BHP1000/TC_Charger/(commit log)

2026-04-05 Initial release: ESP32-S3 CAN controller for HK-LF-115-58 6.6kW OBC
    - Full CAN bus control (250kbps, extended frames) for TC Standard charger
    - Serial command interface: resume/stop/sleep/wake, voltage/current adjust
    - Buddy charge mode for charging external batteries with auto-restore
    - Energy tracking: session, previous, lifetime (NVS persistent)
    - Range estimation: Wh-to-miles with charge time calculator
    - BLE telemetry + command characteristic (22-byte binary, 1Hz notify)
    - WiFi AP fallback (JSON API at 192.168.4.1)
    - Pulse charging EMA smoothing for accurate display
    - 7-page OLED display, RGB status LED, GPS, compass, NTC thermal array
    - RS485 Modbus to ESP32-C3 daughter board (temp nod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
    [TC Standard OBC CAN Protocal .xlsx]
2026-04-05 Add charger configuration code 9000/HD623 and CAN spec details
2026-04-05 Fix CAN transceiver info: CJMCU-1051 works at 3.3V, only 5V damages ESP32
2026-04-05 Add outlet presets, thermal zones, TEST/DEV mode, CAN inter-module, sensor calibration
    Outlet Presets (saved to NVS):
    - A: 110V/15A (1650W), B: 110V/20A (2200W), C: 110V/30A (3300W)
    - D: 220V/15A (3300W), E: 220V/30A (6600W)
    - G: EV Station (user sets amps, CP dummy resistor)
    - U: User defined (custom voltage + amps)
    - F: TEST/DEV (all safety disabled)
    Thermal Protection (battery temps only, charger temp excluded):
    - NORMAL: <140F, CAUTION: 140-194F, DANGER: 194-248F, CRITICAL: >248F
    - Linear derating through CAUTION (100-50%) and DANGER (50-0%)
    - Per-sensor enable/disable: NTC T1-T5, BMS Temp1/2
    - Per-sensor calibration offset in Fahrenheit, saved to NVS
    Multi-char Command Protocol:
    - OA-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
2026-04-05 Fix declaration ordering: forward decls before first use, remove duplicate defines and dead code
    [TC_Charger_MainBrain.ino]
2026-04-05 Critical code review fixes: declaration ordering, BLE, debounce, safety
    CRITICAL fixes:
    - C1: Move safety_state declaration before CAN driver (was compile error)
    - C2: BLE service handle count increased to 40 (was 15, only 5 chars registered)
    - C3: Add null guard in ble_server_update for partial BLE init
    WARNING fixes:
    - W1: Serial multi-char T commands (TZ, TS, TC) now buffered correctly
    Single 't' for schedule toggle still works via fallthrough
    - W2: Button debounce: check timer BEFORE updating last_raw (was swallowing transitions)
    - W3: Remove incorrect prev session duration calc when session_start==0
    - W6: CAN inter-module SET_AMPS/SET_VOLTS clamped to charger hardware limits
    - W7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
    [TC_Charger_MainBrain.ino]
2026-04-05 Add comprehensive Arduino IDE setup guide with troubleshooting and hardware requirements
2026-04-05 Suppress CAN TX error spam when unplugged, add NVS backup/restore commands
    - Remove per-frame CAN TX error log (STATUS line already shows UNPLUGGED)
    - Add NVS commands for manual value restore after flash erase:
    ND - Dump all NVS values with restore commands
    NLW,500 - Set lifetime Wh
    NLA,6.5 - Set lifetime Ah
    NE,32.0 - Set efficiency Wh/mile
    - ND output includes exact restore commands for every saved setting
    - Works via Serial, BLE, and WiFi
    [TC_Charger_MainBrain.ino]
2026-04-05 Add comprehensive USER_GUIDE.md, suppress CAN TX spam, update README
    - USER_GUIDE.md: Complete operating manual covering all features:
    Quick start, all commands reference, charge profiles, outlet presets,
    buddy mode, maintenance mode, scheduled charging, thermal protection,
    sensor calibration, TEST/DEV mode, energy tracking, NVS backup/restore,
    BLE/WiFi API reference, CAN inter-module protocol, OLED pages,
    RGB LED states, and troubleshooting guide
    - README.md: Added hardware requirements section with minimum specs,
    comprehensive Arduino IDE setup with every Tools menu setting,
    troubleshooting for boot loops, blank serial, and flash errors
    - Firmware: Suppressed CAN TX error spa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
2026-04-05 Add cost tracking, completion notifications, thermal prediction, time-to-target, GPS source selection
    Electricity Cost Tracking:
    - NC,0.12: set cost per kWh, NF,42.30: restore lifetime cost
    - Per-outlet cost rate (EV stations default to free)
    - Session cost, lifetime cost (paid), free charger kWh tracked separately
    - Saved to NVS, shown in status line and p report
    Charge Completion Notification:
    - BLE notification via session_end characteristic (...26b2)
    - 22-byte packet: start/end voltage, Wh, Ah, duration, profile, outlet, cost
    - Buzzer GPIO support (set BUZZER_PIN, -1 = disabled)
    - App receives packet to log full charge history
    Time-to-Target Estimates:
    - p report shows estimated minute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
    [TC_Charger_MainBrain.ino]
2026-04-05 Replace buzzer with BLE notify + RGB flash, add TPMS CAN listener
    - Remove buzzer GPIO code, replace completion alert with RGB LED flash (3x green)
    - BLE notification still sent on charge complete (session end characteristic)
    - Add TPMS data receiver from VESC module via CAN (0x1C000010)
    - Front/rear PSI and temperature (Fahrenheit)
    - Toggleable: TPMS1 (enable) / TPMS0 (disable)
    - 60-second timeout marks sensor data as STALE
    - Shown in p report and WiFi /status JSON
    - Physical switches/buttons with LEDs planned for future GPIO wiring
    Compiled: 1,337,123 bytes (42%), 52,760 bytes RAM (16%)
    [TC_Charger_MainBrain.ino]
2026-04-07 v2.0.0: NimBLE migration, TPMS BLE scanner, MQTT, direct commands
    Major firmware update:
    - Migrated BLE from stock ESP32 library to NimBLE-Arduino 2.5.0
    - Added TPMS BLE passive scanner for CozyLife/ZEEPIN valve cap sensors
    - TPMS: discovery, MAC assignment, decode, EMA smoothing, slow leak detection
    - Added WiFi STA + MQTT for Home Assistant with auto-discovery
    - Added direct value set commands (SV/SA/SM/SR/SP/SO)
    - Fixed CAN bus-off recovery for charger hot-plug detection
    - Fixed BLE write command handler (NimBLEAttValue)
    - Added firmware versioning, changelog, timestamps on status line
    - Added COMM_INTERFACE_BLUEPRINT.md (full integration reference)
    - Added TPMS_PROTOCOL.md (complete sens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
    [TC_Charger_MainBrain.ino]
